momonala/hyperscope-v2/docs/photos/esp32-hw394-devkit-top.png

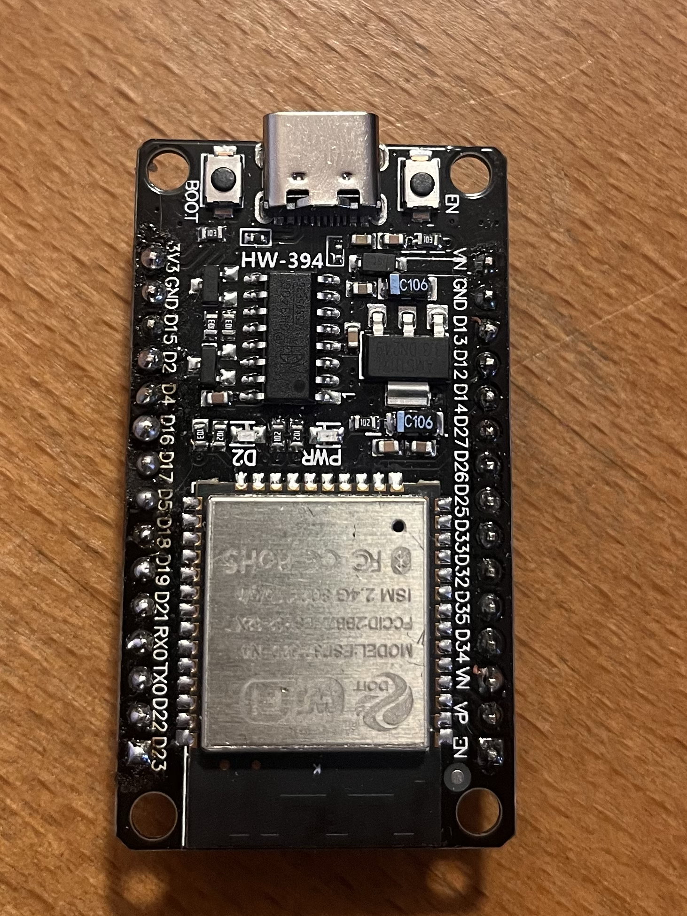
docs/photos/esp32-hw394-devkit-top.png
