momonala/hyperscope-v2/README.md

# hyperscope




Microscope photography rig: a DSLR shoots timelapses over USB, two steppers drive the stage knobs, and a correction CLI flattens the resulting frames.

## Quick start

```bash
git clone https://github.com/momonala/hyperscope-v2.git
cd hyperscope-v2
uv sync
./test-and-lint.sh   # pytest, ruff format, ruff check
```

Needs Python 3.12+, [uv](https://github.com/astral-sh/uv), and `brew install gphoto2` for camera control.

**Shoot a timelapse** — configures the camera for unattended shooting, then shoots until Ctrl+C:

```bash
uv run python src/camera_control.py
```

Frames land in `data/media/<YYYYMMDD>/` as `<date>_<time>_<shot>.jpg`.

**Correct the frames** — dark-frame subtraction and flat-field normalization:

```bash
uv run python src/flat_field_correction.py \
  --flat data/calibration/2x/flat_00.JPG \
  --dark data/calibration/dark.JPG \
  --raw data/media/20260403/20260403_210143_0001.jpg
```

`--flat` and `--raw` repeat, to average several flats or batch several raws. Output goes to `data/output/` unless `--output` says otherwise.

**Drive the stage** — needs `arduino-cli` with the `esp32:esp32` core plus the `TMCStepper` and `FastAccelStepper` libraries:

```bash
arduino-cli compile --fqbn esp32:esp32:esp32 firmware/hyperscope_stage
arduino-cli upload  --fqbn "esp32:esp32:esp32:UploadSpeed=115200" -p /dev/cu.usbserial-XXXX firmware/hyperscope_stage
arduino-cli monitor -p /dev/cu.usbserial-XXXX -c baudrate=115200
```

Then talk to it from the host. `status` resets the board and prints its boot banner, which is how you confirm the driver answered:

```bash
uv run python src/stage.py status
uv run python src/stage.py send "MOVE X3200"   # one knob revolution
uv run python src/stage.py jog                  # tap arrows to step, hold to run
```

The driver only answers once its 12 V supply is on. If the banner says `driver not responding`, see [`docs/hardware.md`](docs/hardware.md).

## How it works

Capture, correction, and the stage are three independent programs, joined only by the files in `data/`.

**Capture.** `camera_control.py` drives the camera through gPhoto2 and captures to the camera's internal RAM rather than its card, so continuous shooting keeps up, then writes each frame to disk.

**Correction.** `flat_field_correction.py` computes `(raw - dark) / (flat - dark)` per pixel and renormalizes each channel to mid-grey by its median, removing vignetting and sensor non-uniformity. It crops the outer 200 px first: the sensor corners fall outside the optical circle, where near-zero flat values would blow up the ratio.

**Stage.** An ESP32 drives two TMC2209 drivers in UART mode, which set current and microstepping in software rather than by trimpot. Positions are in microsteps, 3200 per knob revolution at 16 microsteps. Wiring, pin map, serial protocol, and the bring-up checklist are in [`docs/hardware.md`](docs/hardware.md).

## Configuration

| What | Where |
|---|---|
| Shot interval, media directory | `SHOOT_INTERVAL_SECONDS` and `MEDIA_DIR` in `src/camera_control.py` |
| Correction kernel, edge crop | Module constants in `src/flat_field_correction.py` |
| Stage pins, current, speeds | `firmware/hyperscope_stage/config.h` |

Camera widget names and values are Nikon-specific. Check yours before trusting the enums in `src/camera_settings.py`:

```bash
gphoto2 --get-config /main/capturesettings/capturemode
```

## Project structure

```
src/
├── camera_control.py         # gPhoto2 timelapse capture loop
├── camera_settings.py        # StrEnums for gPhoto2 config values (Nikon)
├── flat_field_correction.py  # Typer CLI: dark/flat calibration pipeline
└── stage.py                  # Serial client for the stage controller
firmware/hyperscope_stage/    # ESP32 + TMC2209 stage controller (Arduino)
docs/
├── hardware.md               # BOM, wiring, pin map, serial protocol, bring-up
├── diagrams/                 # Wiring SVG, generated by make_wiring_diagram.py
├── datasheets/               # TMC2209, BTT driver board, ESP32-WROOM-32D
└── photos/                   # Board photos
data/                         # Gitignored
├── calibration/              # Flat-field and dark-frame reference images
├── media/                    # Captured frames
└── output/                   # Corrected frames
```

## Key decisions

- **Three programs, joined by files.** Capture, correction, and the stage share nothing but `data/`. Each can be run, tested, and replaced alone, at the cost of no coordination between shots and moves yet.
- **A separate microcontroller for the stage.** Step timing needs microsecond accuracy that a Linux host cannot promise, so an ESP32 generates steps and the host only sends commands over serial. Arduino rather than PlatformIO or MicroPython because the two driver libraries are Arduino-native.
- **TMC2209 in UART mode.** Current, microstepping, and chopper mode are set from `config.h` instead of a trimpot and solder jumpers, and the firmware can read the driver back to detect a reset. The cost is one shared single-wire bus that every driver must be addressed on correctly.
- **Rated current, StealthChop, 47 kHz PWM.** The knobs bind at spots, so the motors run at their rated 1 A RMS; 25 % hold keeps the drivers cool, the supply within a 2 A limit, and the motors silent at rest. The default 35 kHz PWM produced an audible whirr at standstill.
- **Capture to the camera's RAM.** Writing to the card between shots was the bottleneck for continuous shooting. Frames are pulled over USB instead, so a dropped USB link loses the shot.
- **Positions in microsteps.** Nothing has measured the knob pitch yet, so the firmware stays in its native unit rather than guessing a conversion.

## Limitations

- **Stage units are microsteps, not microns.** Converting needs the knob pitch per revolution, which is unmeasured.
- **No homing or limits.** Nothing knows where the stage ends. The driver's DIAG pins are snipped, so a future stall-based end stop has to read StallGuard over the UART.
- **Capture and stage do not talk.** `src/stage.py` drives the stage by hand, but nothing moves it between shots during a timelapse.

_Last updated: 2026-09-20_
