momonala/hyperscope-v2/docs/hardware.md

# XY stage hardware

Two NEMA 17 steppers turn the microscope's X and Y stage knobs through 3D-printed mounts. An ESP32 drives them through two TMC2209 drivers and takes commands over USB serial, with an analog joystick for manual jogging. Firmware lives in `firmware/hyperscope_stage/`; the pin map there (`config.h`) is the source of truth and this document mirrors it.

## Bill of materials

| Part | Detail | Notes |
|---|---|---|
| 2x NEMA 17 stepper | MVPower, 1.5 A/phase, 1.8°, 4-wire | Run at 1.0 A RMS in firmware (1.5 A peak = ~1.06 A RMS) |
| ESP32 DevKit | HW-394, 30-pin DOIT DevKit V1 layout, USB-C | Powered from Mac USB; pins labelled D<n> = GPIO n |
| 2x TMC2209 | BIGTREETECH V1.3 (V1.2 docs in `datasheets/`) | UART mode, 0.11 Ω sense. V1.3 silkscreen says **VS** for VM and **VIO** for VDD |
| Bench PSU | Set to **12 V**, ≥ 2 A | Motor supply only |
| XY joystick | 5 V type, pins GND/+5V/VRX/VRY/SW | **Power from 3V3**, not 5 V |
| 2x 100 µF electrolytic, ≥ 25 V | Across VM/GND at each driver | Absorbs motor back-EMF |
| 1x 1 kΩ resistor | ESP32 TX → UART bus | Single-wire UART |
| Heatsinks for TMC2209 | Included with drivers | Do not let them touch pins |

## Power

- **Motor supply (VM)**: 12 V from the PSU to VM and GND on both drivers. Star the two drivers from the PSU terminals; do not daisy-chain through thin dupont wire.
- **Logic**: ESP32 from USB. Each driver's VDD (VCC_IO) pin from the ESP32 **3V3** pin. This sets the driver's IO level to 3.3 V so its UART replies do not overdrive the ESP32.
- **Common ground**: PSU GND, driver GND, and ESP32 GND must all be joined.
- **Sequencing**: plug the motors into the drivers first, then power the PSU. Never connect or disconnect a motor while VM is live. Set the PSU current limit to 2 A on first power-up.

## Wiring diagram

XY stage wiring

`docs/diagrams/wiring.svg` is generated by `docs/diagrams/make_wiring_diagram.py`; edit the script, not the SVG. A PNG render sits beside it. Re-render with headless Brave:

```bash
uv run python docs/diagrams/make_wiring_diagram.py
"/Applications/Brave Browser.app/Contents/MacOS/Brave Browser" --headless --disable-gpu --hide-scrollbars \
  --window-size=1500,1320 --screenshot="$PWD/docs/diagrams/wiring.png" "file://$PWD/docs/diagrams/wiring.svg"
```

## Carrier PCB

The DevKit and the driver modules plug into a carrier PCB. KiCad sources, Gerbers, the generator script, and fabrication settings live in [`hardware/pcb/README.md`](../hardware/pcb/README.md). The breadboard notes below are for bench debugging.

## Breadboard placement

The driver is 0.6" wide, so it straddles the centre trench like a wide DIP. Two extra pins stand on the short edge beside the potentiometer, soldered and pointing down like the main headers: **DIAG** and **INDEX**. The bare plated hole between them is the Vref test point and carries no pin. Both pins are driver outputs, and neither is used here.

**Snip or desolder DIAG and INDEX before fitting the module.** They sit on the same line as EN, one and two tenths of an inch inboard, and a breadboard tie strip is five holes long, so there is no seating position that works:

| Seating | Result |
|---|---|
| EN row in an outer column | DIAG and INDEX drop into EN's own tie strip |
| EN row in the column beside the trench | DIAG and INDEX hit the solid trench floor and the module cannot seat |

Bridging them is not an option. EN is an input driven by the ESP32, while DIAG and INDEX are push-pull outputs, so shorting the three makes two outputs fight the microcontroller. INDEX also pulses once per electrical cycle, which would toggle EN and cut the driver out mid-move. BIGTREETECH's own note (`datasheets/btt-tmc2209-diag-pin-note.pdf`) says to cut the DIAG pin whenever the function is unused.

Cutting DIAG costs only the hardware stall line. StallGuard still works over UART through `SGTHRS` and `SG_RESULT`, which is fast enough to home a microscope stage.

With those two pins gone, seat the module so the **EN/STEP/DIR row is in an outer column**. Run the 12 V supply into the board's power rails, put the 100 µF capacitor across the rails, and jumper VS and GND from there.

Breadboard contacts are rated around 1 A. That is fine for bench testing at 1 A RMS with short solid-core wires, but move to a soldered board before leaving the stage running unattended.

## Pin map

### ESP32 to TMC2209

The driver signals sit on the DevKit's 3V3-side row in the same left-to-right order as the module header. With the USB-C out of the left board edge that row is the lower one, nearest the board edge, and the traces pass under the DevKit.

| Signal | X driver | Y driver | ESP32 | Notes |
|---|---|---|---|---|
| EN | EN | EN | D4 (shared) | Active low. The module pulls EN low (20 kΩ) and GPIO 4 has a weak internal pull-down at reset, so the PCB adds a 2.2 kΩ pull-up to 3V3 (about 2.85 V, above the driver's 2.3 V threshold); otherwise both drivers are enabled at pot current while D4 floats during boot |
| PDN_UART (header pin 4) | PDN | PDN | D17 direct, D16 via 1 kOhm | Both drivers on one wire, one resistor |
| STEP | STEP | | D5 | Strapping pin, sampled only at reset |
| DIR | DIR | | D18 | |
| STEP | | STEP | D19 | |
| DIR | | DIR | D21 | |
| DIAG | DIAG | | D13 | Via 1 kOhm and a solder jumper on the PCB, see below |
| DIAG | | DIAG | D22 | |
| Motor LED | D2 (blue) | | D32 | Via 100 Ohm, lit while X moves (PCB rev C) |
| Motor LED | | D3 (blue) | D23 | Via 100 Ohm, lit while Y moves |
| VDD (marked **VIO** on V1.3) | 3V3 | 3V3 | 3V3 | Sets the driver's logic level |
| GND (logic side) | GND | GND | GND | |
| MS1 | GND | 3V3 | | UART address: X = 0, Y = 1. Solder jumpers on the PCB |
| MS2 | GND | GND | | |
| CLK, PDN (pin 5) | open | open | | |
| INDEX | open | open | | |

The BTT board connects UART to header pin 4 from the factory (manual §8.1). Pin 5 is a second PDN pad that is not connected; leave it alone. In UART mode the MS1/MS2 pins stop selecting microsteps and become the address bits, and firmware sets 16 microsteps and current over UART. The Vref potentiometer is ignored (`I_scale_analog = 0`).

**DIAG jumper.** The module's two extra pins beside EN are DIAG and INDEX, and which is which was not confirmed from the module photos. Each socket has a three-pad solder jumper on the back of the PCB: move a motor, probe which of the two pads pulses (that one is INDEX), then bridge the centre pad to the other one.

### Single-wire UART detail

```
ESP32 GPIO16 (TX) ──[1 kΩ]──┬── PDN_UART (X driver)
ESP32 GPIO17 (RX) ──────────┤
                            └── PDN_UART (Y driver)
```

The resistor lets the driver pull the line while the ESP32 TX is idle high.

### Motors

| Driver pin | Motor wire |
|---|---|
| A2, A1 | Coil A pair |
| B1, B2 | Coil B pair |

Find the pairs with a multimeter: the two wires of one coil read a few ohms between them, and open to the other pair. Which pair is "A" does not matter. Swapping the two wires of one coil reverses direction; flip `JOY_INVERT_X/Y` in `config.h` instead of rewiring.

### Joystick

| Joystick pin | ESP32 |
|---|---|
| GND | GND |
| +5V | **3V3** |
| VRX | D34 |
| VRY | D35 |
| SW | D33 (internal pull-up) |

On the PCB the joystick plugs into a 1x5 pin header with dupont leads, with a 100 nF filter on each axis.

D34 and D35 are input-only ADC1 pins with no pull-ups, which is why SW goes to D33 instead.

### Pins to avoid on this board

GPIO 0, 2, 12, 15 are boot-strapping pins; GPIO 6–11 are the flash; GPIO 1/3 are the USB serial. None of them are used above. GPIO 5 is also sampled at reset, but only for SDIO timing, and a STEP line there is harmless because the drivers are disabled until the firmware enables them.

## Firmware

Libraries: `TMCStepper` 0.7.3 and `FastAccelStepper` 1.2.5, installed with `arduino-cli lib install TMCStepper FastAccelStepper`. Board FQBN `esp32:esp32:esp32`.

Using the `arduino` alias from `arduino-cli-tool`:

```bash
arduino run --path firmware/hyperscope_stage
```

or directly:

```bash
arduino-cli compile --fqbn esp32:esp32:esp32 firmware/hyperscope_stage
arduino-cli upload  --fqbn "esp32:esp32:esp32:UploadSpeed=115200" -p /dev/cu.usbserial-XXXX firmware/hyperscope_stage
arduino-cli monitor -p /dev/cu.usbserial-XXXX -c baudrate=115200
```

The default upload speed of 921600 baud makes this board's CH340 drop out partway through with "The chip stopped responding". Pinning `UploadSpeed=115200` is slower but reliable.

### Driver settings applied at boot

| Setting | Value | Why |
|---|---|-----|
| RMS current | 1000 mA, hold 25 % | The motor's rated 1.5 A peak; 600 mA could not push through the knobs' sticky spots. Fanless BTT modules are fine to ~1.2 A RMS |
| Microsteps | 16 (3200/rev) | Smooth, and FastAccelStepper handles the step rate easily |
| Chopper | StealthChop, PWM at 47 kHz | Silent; the default 35 kHz gave an audible whirr at standstill |

### Serial protocol

115200 baud, newline-terminated, case-insensitive. Every command answers `ok` or `err <reason>`. Lines starting with `#` are informational.

| Command | Effect |
|---|---|
| `?` | Print position, motion state, settings, and each driver's microsteps and current read back over UART |
| `MOVE X<n> Y<n>` | Relative move in microsteps; either axis optional |
| `GOTO X<n> Y<n>` | Absolute move in microsteps |
| `JOG X<hz> Y<hz>` | Run at a signed velocity in microsteps/s until the next command; 0 stops that axis. Used by `stage.py jog` |
| `ZERO` | Set current position as origin |
| `STOP` | Decelerate to a stop |
| `HALT` | Stop immediately |
| `SPEED <hz>` | Max speed in microsteps/s for serial moves |
| `ACCEL <hz/s²>` | Acceleration |
| `EN <0/1>` | Disable or enable drivers (motors turn freely when disabled) |
| `JOY <0/1>` | Disable or enable joystick jogging |
| `CUR <mA>` | Set RMS current on both drivers, 100 to 1500 |
| `JOYRAW` | Raw joystick readings and the jog speeds they produce |
| `DIRTEST [X\|Y]` | Step each way and read that driver's counter to verify STEP and direction (default X) |
| `JOYCAL` | Re-measure the joystick's resting centre |
| `WAIT` | Block until both axes stop |

Joystick: deflection sets velocity on a squared curve. The button toggles fine (400 Hz max, an eighth of a knob turn per second) and coarse (4000 Hz max, 1.25 turns per second) jog. Releasing the stick decelerates to a stop.

`PIN_JOY_X` and `PIN_JOY_Y` say which analog input drives which motor, not which pin is which on the module. The module's own VRX and VRY labels follow its body, so once it is mounted they need not line up with the throw you think of as left and right. Swap the two constants if the axes feel exchanged, and flip `JOY_INVERT_X` or `JOY_INVERT_Y` if a throw drives the wrong way.

The resting centre is measured at boot rather than assumed to be mid-scale, because these modules do not sit there. This one rests near 1856 on X and 1924 on Y against a full scale of 4095. Assuming 2048 left only about 40 counts of margin on X, which ADC noise crossed on its own and jogged the stage unbidden. Leave the stick alone while the board starts, or send `JOYCAL` afterwards.

`ENABLE_DRIVERS_AT_BOOT` in `config.h` decides whether a reset comes up ready to jog or with the motors free. Set it false while bench testing against a supply whose current limit you are unsure of, so a reset cannot slam it.

The firmware asks each driver on the bus whether it is there, and an axis whose driver stays silent is simply reported unavailable rather than being switched off in the config. Wiring the second driver is all it takes to bring the Y axis up.

## Bring-up checklist

1. **Wire it up with the supply off.** ESP32, the driver's logic side, the UART pair, the capacitor across the rails, and the motor into its coil pairs.
2. **The 12 V supply must be on before the driver will talk.** The TMC2209 runs its digital core off an internal 5 V regulator fed from VS, and VIO only sets the logic level, so with no motor supply the chip is dead and answers nothing on the UART. Set the limit to 2 A, switch on, then reset the ESP32 and look for `X driver ok` and `Y driver ok`, each with a version byte.
3. **Give it enough current.** A stepper driver is a switching regulator, so two motors holding 25 % of 1 A RMS pull well under an amp from a 12 V supply, but acceleration spikes higher. If the supply folds back the TMC2209 browns out and resets to its pin defaults (see below): the motor feels tense but will not turn, or whines. Set the limit to 2 A; it is a ceiling, not a push. If your supply cannot manage that, lower the drivers further with `CUR 400`.
4. **Then move it.** Send `EN 1`, then `MOVE X3200` and `MOVE Y3200` to turn each knob exactly one revolution. The drivers should stay silent and cool.
5. **Check direction.** Decide which way is +X on the stage and flip `JOY_INVERT_X/Y` if needed. Serial direction can be flipped by swapping one coil pair.
6. **Joystick.** Confirm that it jogs, that the centre is dead, and that the button toggles fine/coarse. If it jogs at rest, send `JOYRAW` and compare the readings against the measured centre, then raise `JOY_DEADZONE`.
7. **Heat.** After a few minutes of holding, drivers should be warm, not hot. If the motors are too weak to turn a stiff knob, raise `CUR` in 100 mA steps up to 1300.

### Checking STEP and DIR reach the driver

`DIRTEST X` or `DIRTEST Y` steps a little each way and reads the driver's own microstep counter, so it reports what the driver actually did rather than what it was told. Opposite signs of 320 mean both signals arrive. The same sign both ways means DIR is not reaching the driver; a count other than 320 means STEP pulses are being dropped or the driver is no longer at 16 microsteps (see below). A breadboard contact that looks fine can fail either way, so run this after any rewiring.

### Drivers losing their settings

`?` reads microsteps and current back from each driver. Both should say 16 and the configured current. If a driver shows 8 (X) or 32 (Y), it has reset to its MS-pin defaults and is running on the Vref pot's current: its registers were lost after boot. The usual cause is the 12 V supply folding back on a current spike, both motors energising at once or one accelerating while the other holds, so the PSU limit must be at least 2 A. `DRIVER_ENABLE_SETTLE_MS` in `config.h` spaces the boot-time enable away from the register writes, and the firmware re-checks every driver once a second and re-applies its settings after printing `# <axis> driver lost its settings`. Seeing that line means the supply or that driver's VS, GND, or VIO contact needs attention; the restore only limits the damage.

### When a driver does not answer

The boot banner prints `<axis> driver not responding, that axis is unavailable`, and commands for that axis return `err`. Usual causes, most common first:

- **12 V supply off.** The driver's digital core runs from VS, so without it nothing answers. Check this before anything else.
- UART pair swapped, wrong header pin, or no 1 kOhm resistor on TX.
- Missing common ground between PSU, driver, and ESP32.
- Only Y silent: MS1 not tied to 3V3, so both drivers sit at address 0 and their replies collide.

## Still to measure

- Knob pitch in mm (or µm) per revolution for each axis, so positions can be reported in microns instead of microsteps.
- Any gear ratio built into the printed mounts.
- Whether the knobs have hard stops. If so, StallGuard can act as software end stops, read over UART since the DIAG pins are snipped.

## Photos

In `docs/photos/`: `tmc2209-v1.3-top.png` and `tmc2209-v1.3-bottom.png` show the V1.3 silkscreen (VS, VIO, DIAG) and the soldered DIAG/INDEX header; `esp32-hw394-devkit-top.png` shows the HW-394 board's pin labels.

## References

All in `docs/datasheets/`:

- TMC2209 IC datasheet (register map, UART protocol): download from Analog Devices and save as `trinamic-tmc2209-datasheet.pdf`. The download timed out when this doc was written. https://www.analog.com/media/en/technical-documentation/data-sheets/TMC2209_datasheet_rev1.09.pdf
- `btt-tmc2209-v1.2-manual.pdf` and `btt-tmc2209-v1.2-schematic.pdf`: the driver board. V1.3 has the same pinout; V1.3 docs are not published.
- `btt-tmc2209-diag-pin-note.pdf`: DIAG is output-only on the TMC2209.
- `esp32-wroom-32d-datasheet.pdf`: module datasheet.
- `esp32-devkit-seller-leaflet.pdf`: the seller's generic safety leaflet, kept only because it came with the board. It has no electrical information.
