momonala/hyperscope-v2/docs/photos/tmc2209-v1.3-bottom.png

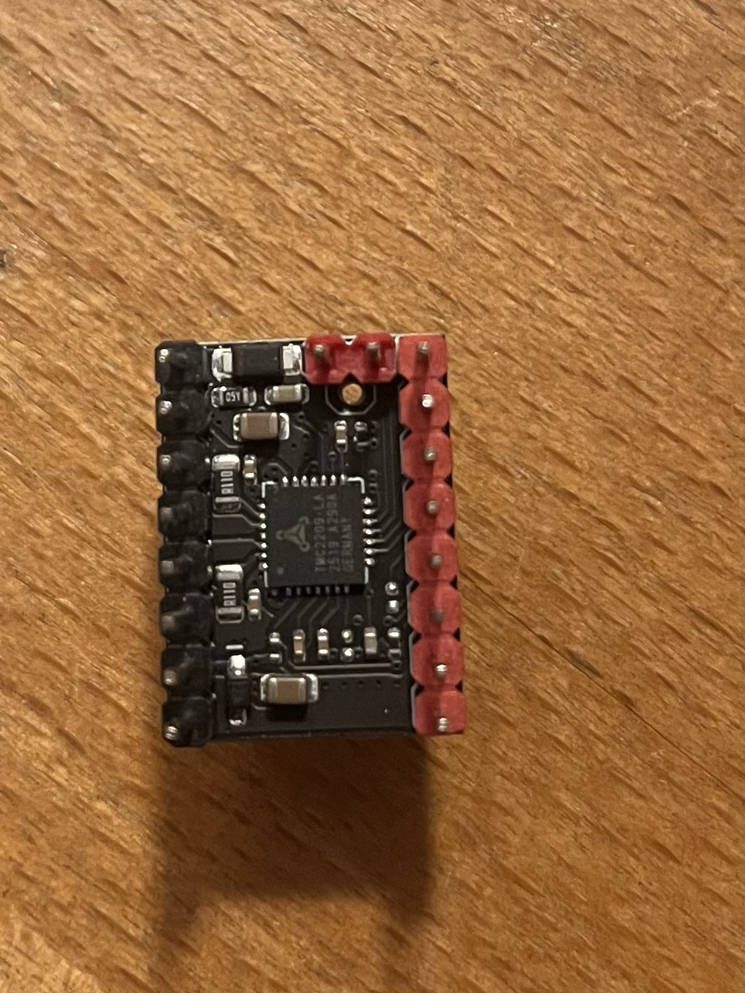
docs/photos/tmc2209-v1.3-bottom.png
