momonala/hyperscope-v2/docs/photos/tmc2209-v1.3-top.png

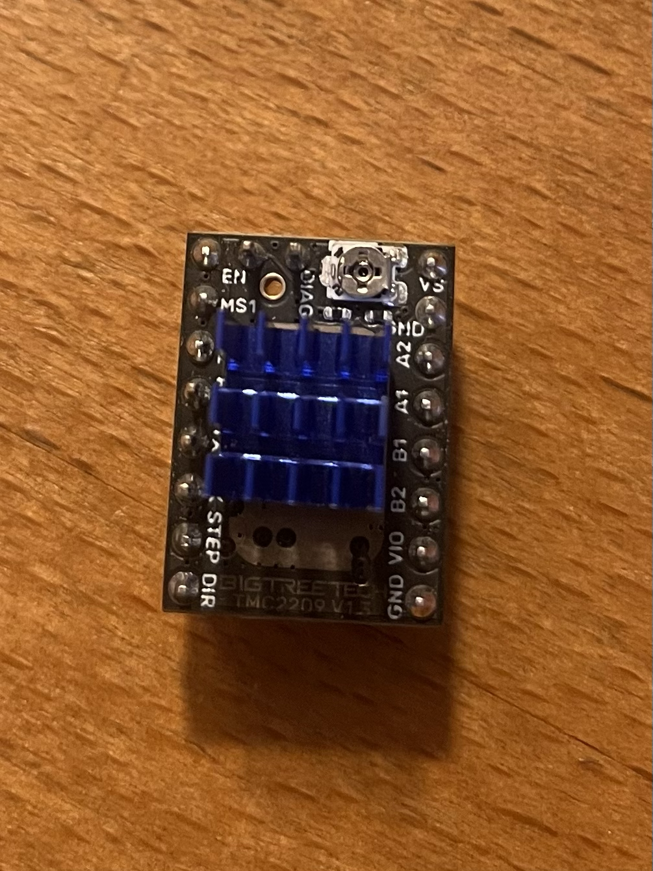
docs/photos/tmc2209-v1.3-top.png
