momonala/hyperscope-v2/docs/diagrams/wiring.png

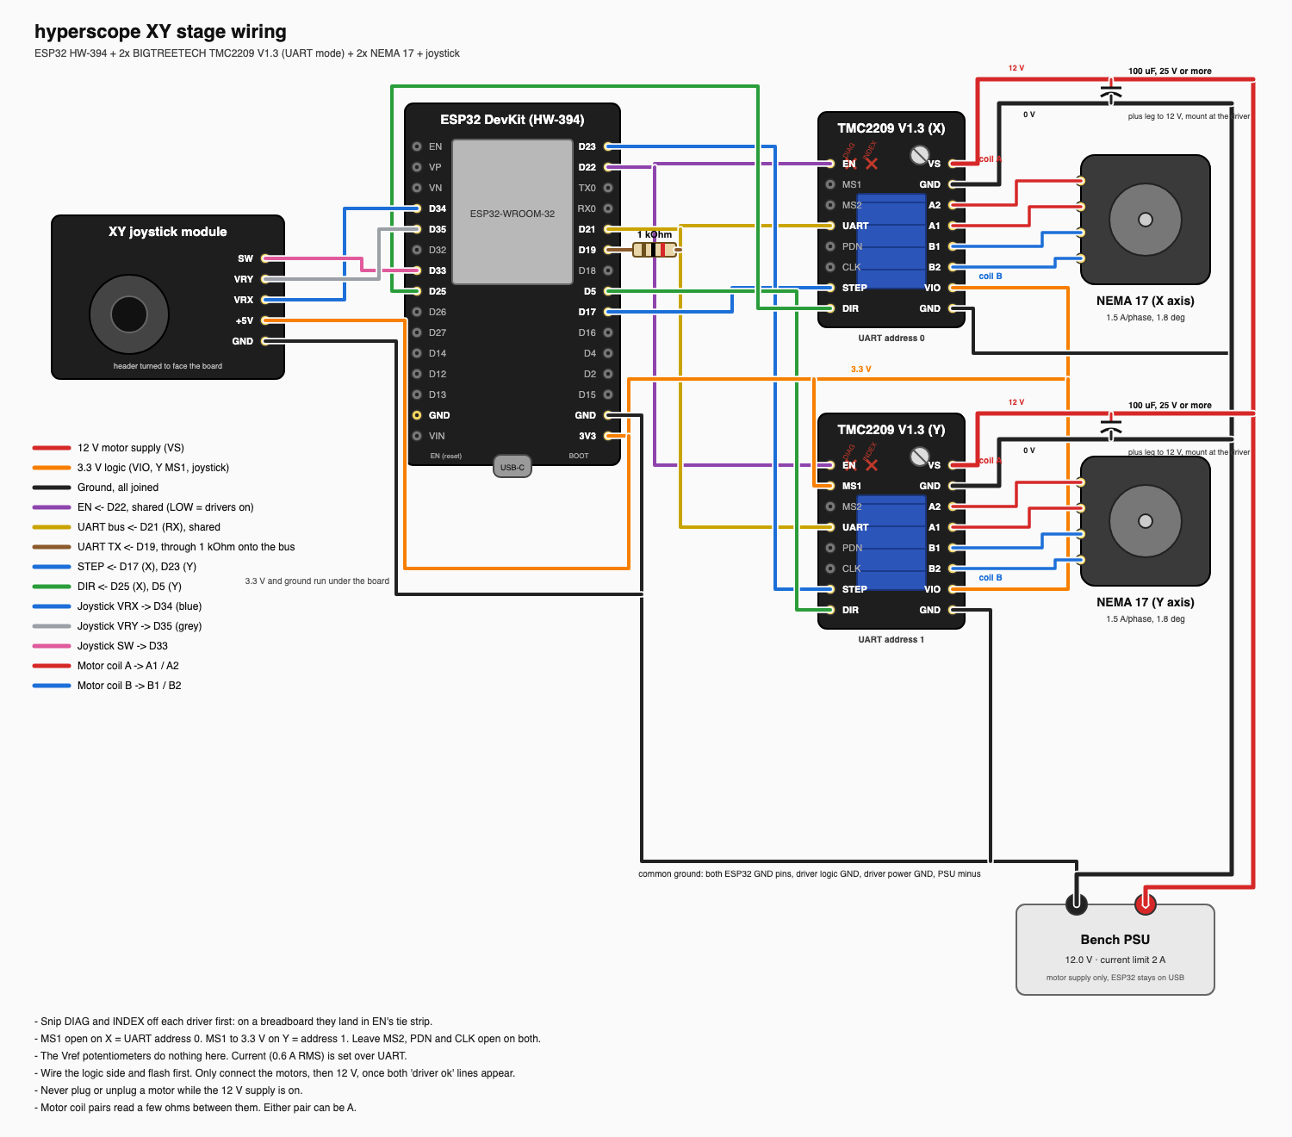
docs/diagrams/wiring.png
