momonala/hyperscope-v2/hardware/pcb/review/schematic.pdf

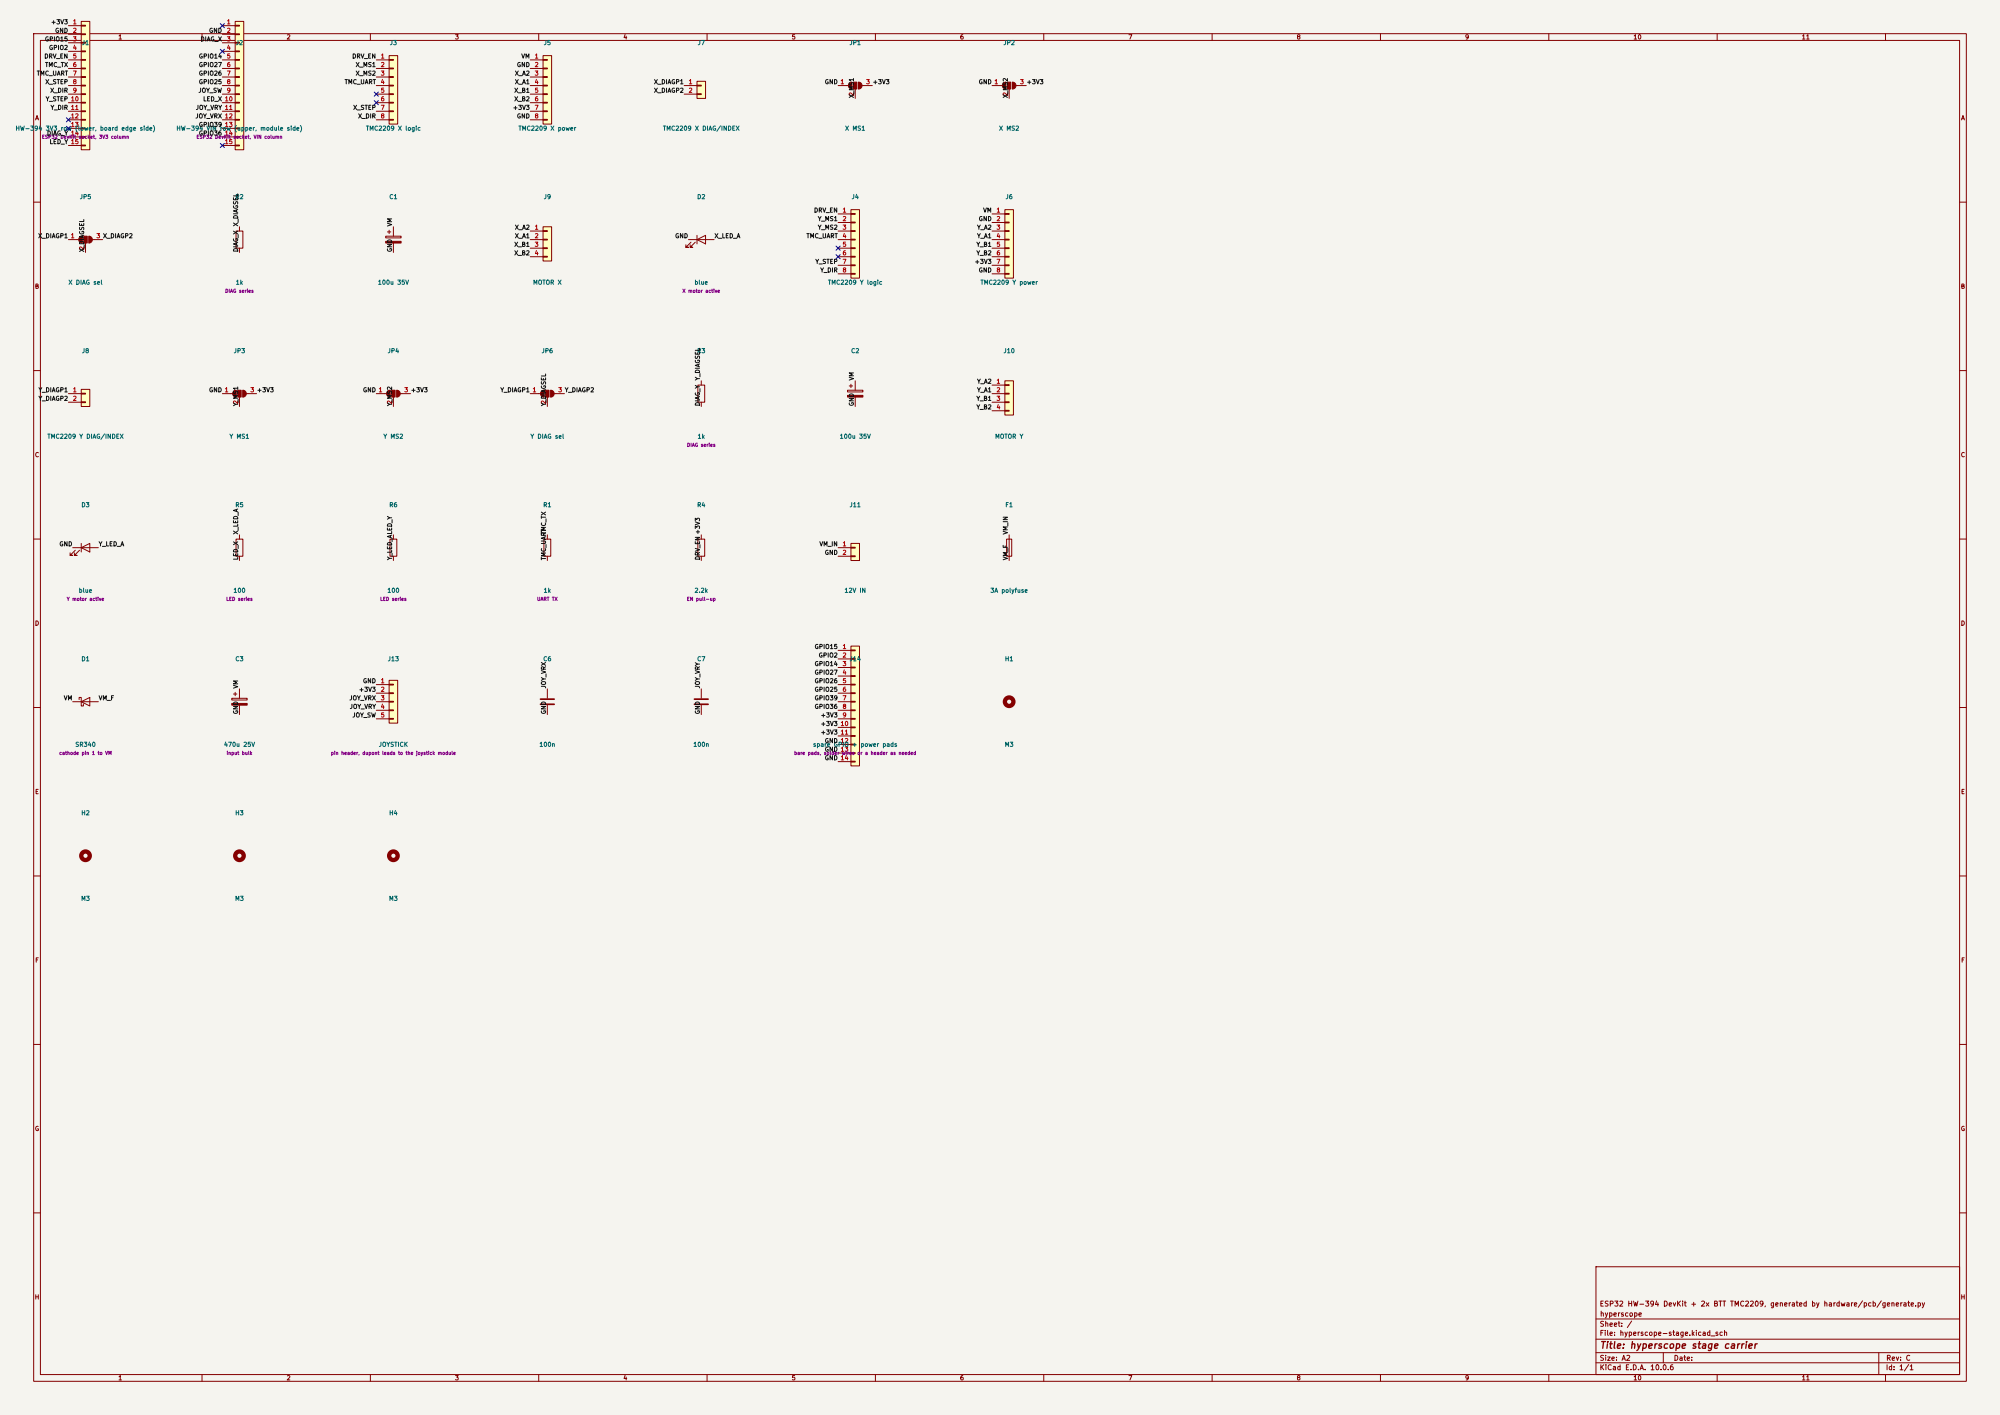
[picture p6: page 1]

J1 HW-394 3V3 row (lower, board edge side) ESP32 DevKit socket, 3V3 column

J2 HW-394 VIN row (upper, module side) ESP32 DevKit socket, VIN column

cathode pin 1 to VM D3

bare pads, solder wires or a header as needed R4

ESP32 HW-394 DevKit + 2x BTT TMC2209, generated by hardware/pcb/generate.py
hyperscope
Sheet: /
File: hyperscope-stage.kicad_sch
Title: hyperscope stage carrier

Size: A2 | Rev: C
KiCad E.D.A. 10.0.6 | Id: 1/1
