momonala/hyperscope-v2/(commit log)

2026-09-20 feat(stage): add ESP32 XY stage firmware and host jog client
    - TMC2209 UART firmware with MOVE/GOTO/JOG serial protocol and joystick jogging
    - run motors at their rated 1 A RMS to push through knob friction
    - stage.py: tap-to-step, hold-to-run keyboard jog with a live rich status panel
    - hardware doc, wiring diagram, datasheets, and board photos
2026-09-20 refactor: consolidate data dirs, drop config module, tidy camera and correction code
    - move captured, calibration, and output frames under gitignored data/
    - delete the [tool.config] shim and its script entry point
    - move dev tooling into a uv dependency group; add pyserial for the stage client
    - camera_control: configure logging only at the entry point, raise SystemExit on missing camera
    - vectorise stretch_contrast and add a flat-field correction test; add test-and-lint.sh
2026-10-03 feat(hardware): add carrier PCB rev B and remap firmware pins to it
    - KiCad project, generator script, Gerbers, and DRC/ERC review output under hardware/pcb/
    - config.h: move driver, UART, and EN pins to the PCB layout; add DIAG pins
    - hardware.md: carrier PCB section, new pin table, DIAG solder-jumper note
    - ignore KiCad and Freerouting scratch files
2026-10-14 feat(hardware): add carrier PCB rev C with corrected driver socket pitch and motor LEDs
    - fix TMC2209 socket row pitch to 12.7 mm; rev B's 15.24 mm did not fit the modules
    - add blue motor-active LEDs on GPIO 32 (X) and 23 (Y), lit by firmware while each axis moves
    - move DIAG to GPIO 13 (X) and 22 (Y) to free pins for the LEDs
    - grow the board to 84 x 72 mm, stand the resistors, regenerate gerbers and review files
