momonala/hyperscope-v2/docs/photos/breadboard-with-ruler.png

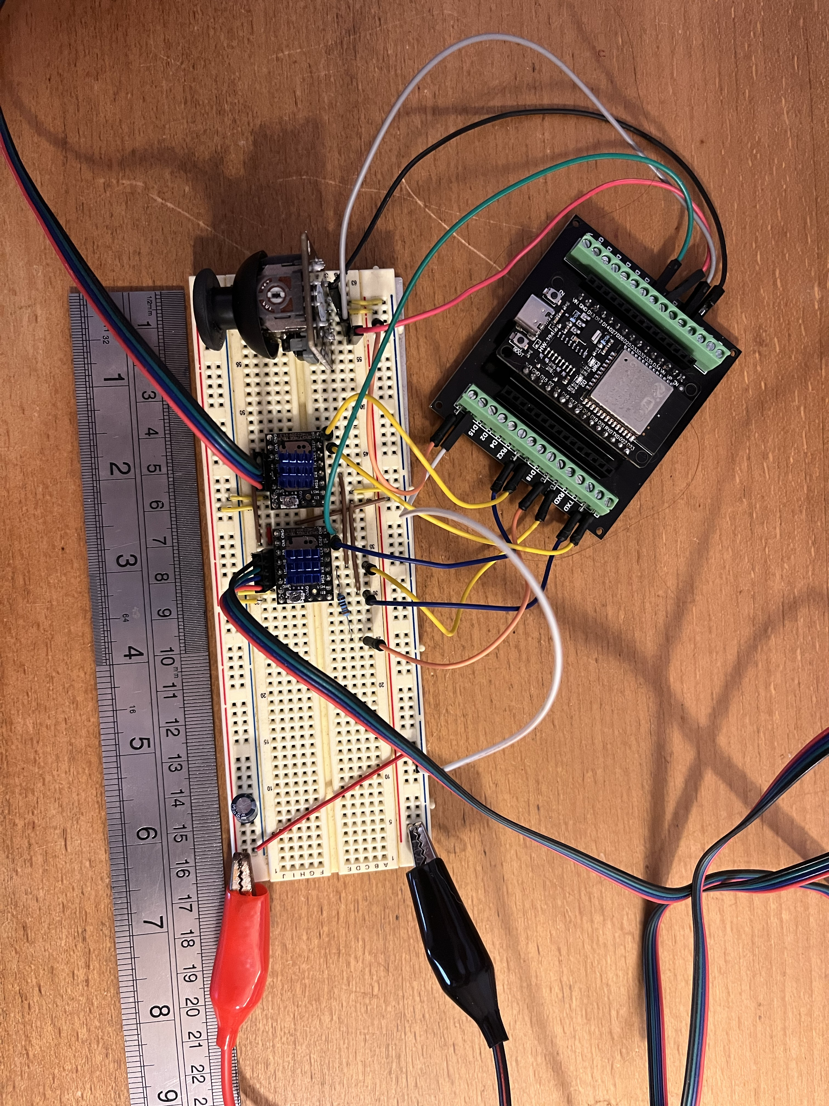
docs/photos/breadboard-with-ruler.png
